Fasahat-Labib/Digital-Snake-Ladder-Game/(list of files, drawings)

Other design files:
NSB_Final Schematic.pdsprj
